Mayel-dev/mesa-voice/hardware/previews/mesa-voice.png

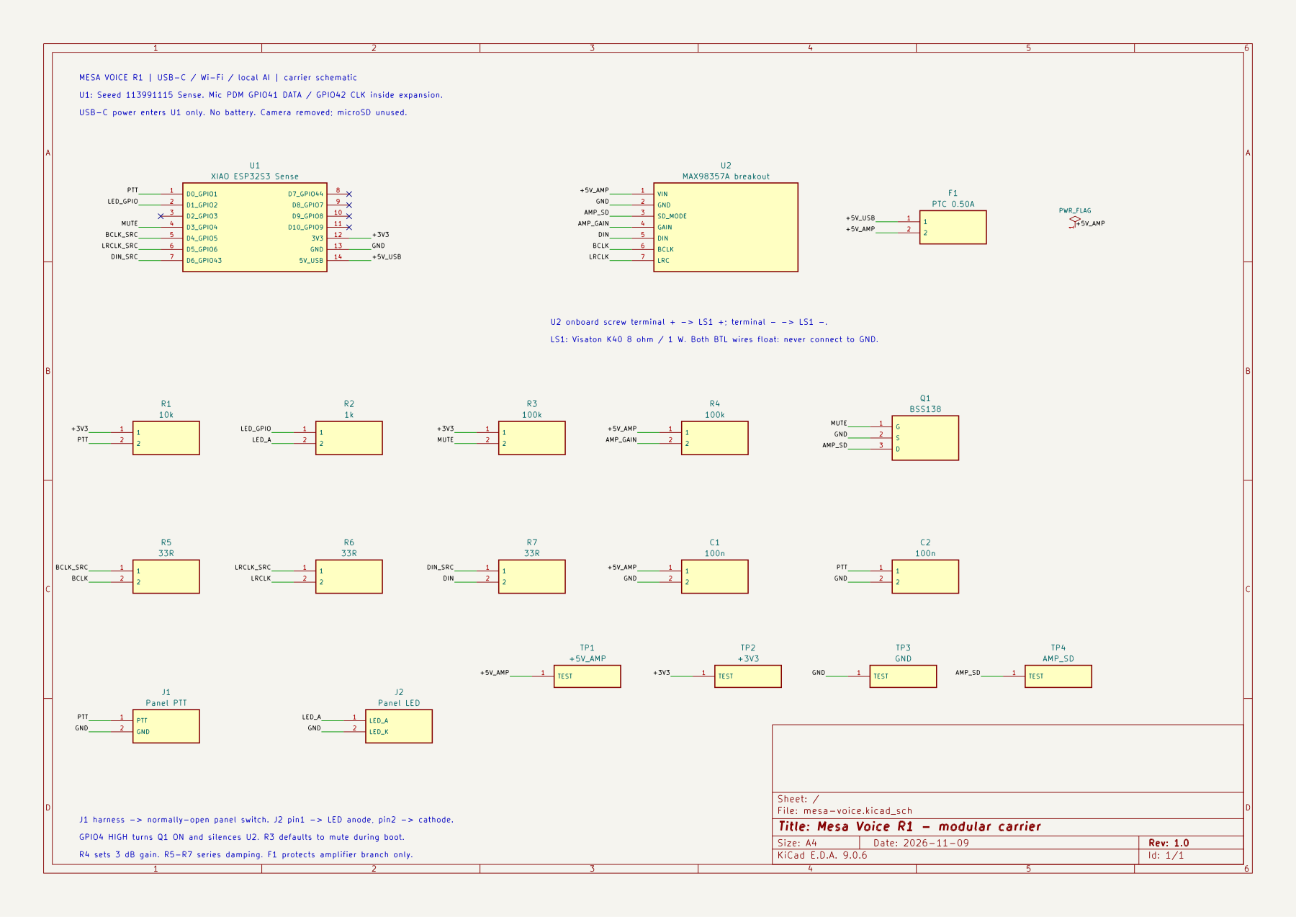
hardware/previews/mesa-voice.png
