Mayel-dev/mesa-voice/hardware/previews/pcb-back.png

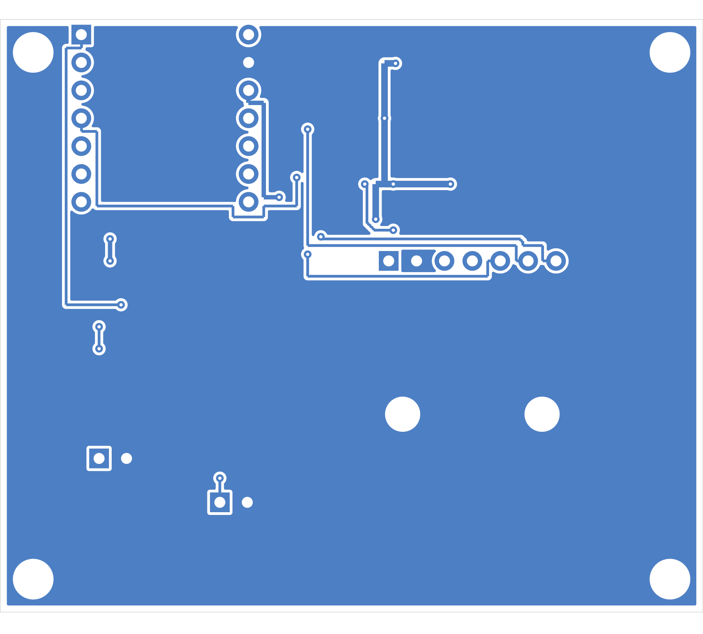
hardware/previews/pcb-back.png
