Mayel-dev/mesa-voice/hardware/previews/pcb-front.png

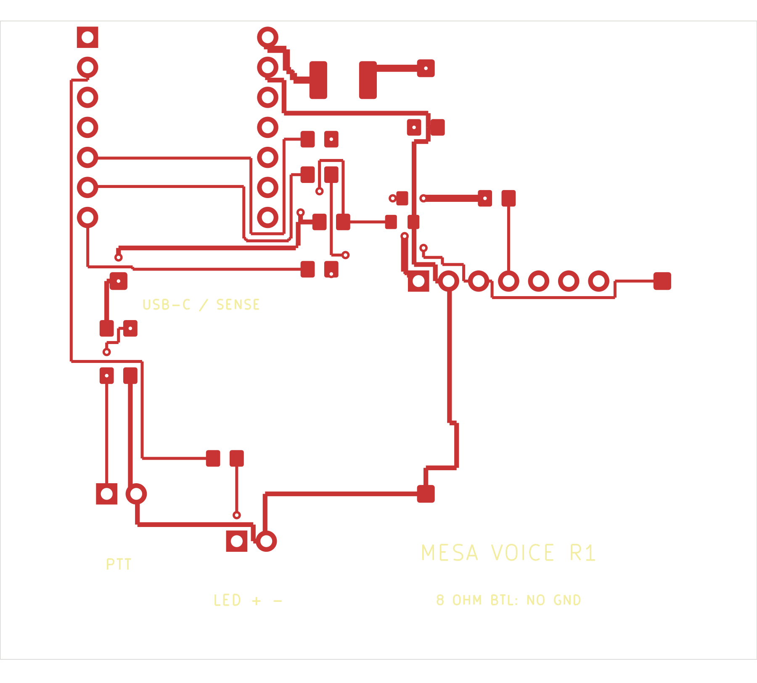
hardware/previews/pcb-front.png
