Mayel-dev/mesa-voice/mechanical/base.png

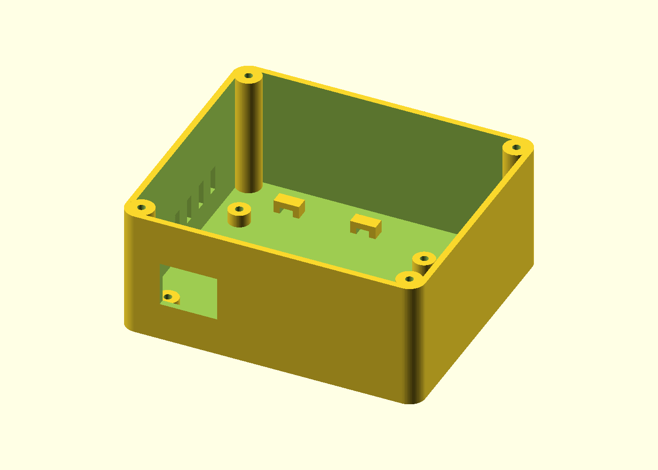
mechanical/base.png
