Mayel-dev/mesa-voice/mechanical/lid.png

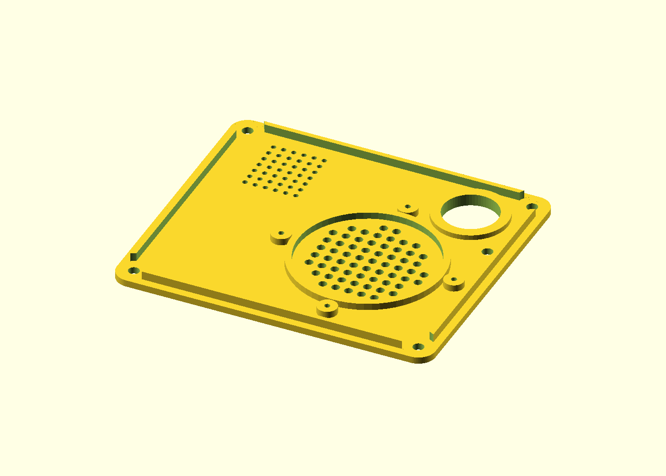
mechanical/lid.png
