Mayel-dev/mesa-voice/mechanical/stl/base.stl

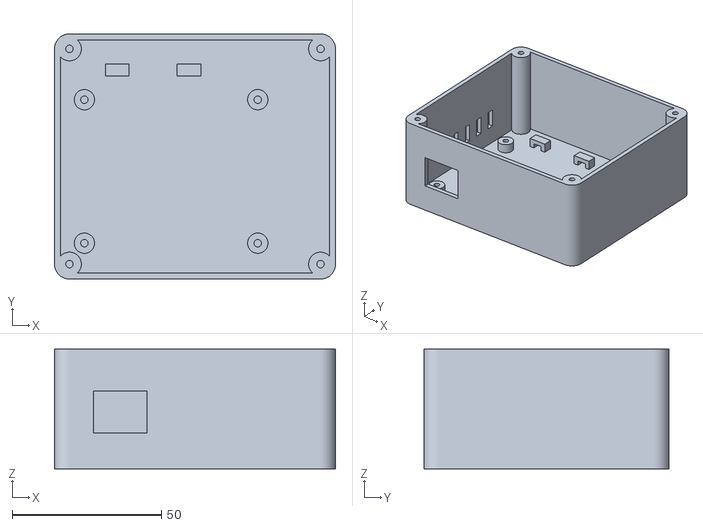
[picture p7: CAD file, 2026-11-11]
mechanical/stl/base.stl
94.0 x 82.0 x 40.0
