Mayel-dev/mesa-voice/mechanical/stl/lid.stl

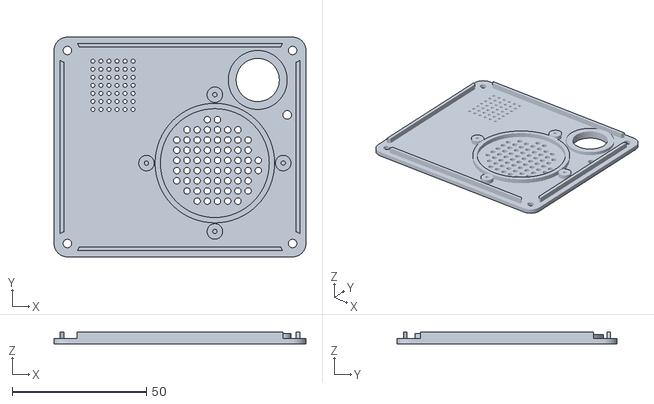
[picture p8: CAD file, 2026-11-11]
mechanical/stl/lid.stl
94.0 x 82.0 x 4.50
