Mayel-dev/mesa-voice/mechanical/stl/speaker_clamp.stl

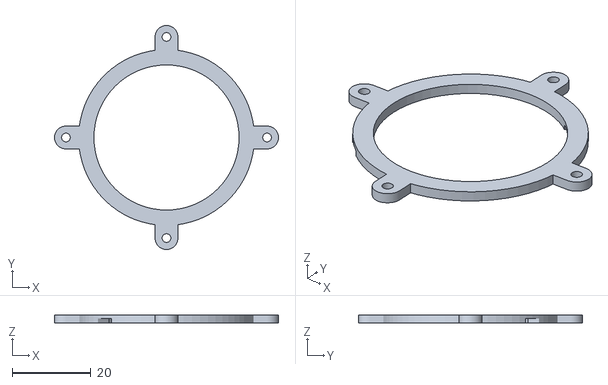
[picture p9: CAD file, 2026-11-11]
mechanical/stl/speaker_clamp.stl
56.8 x 56.8 x 2.00
