Mayel-dev/mesa-voice/hardware/previews/assembly.png

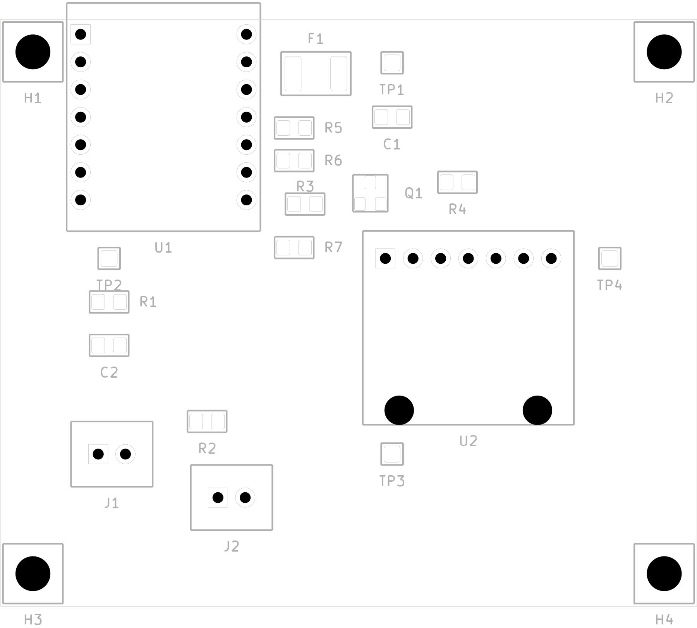
hardware/previews/assembly.png
