Mayel-dev/mesa-voice/hardware/previews/wiring.png

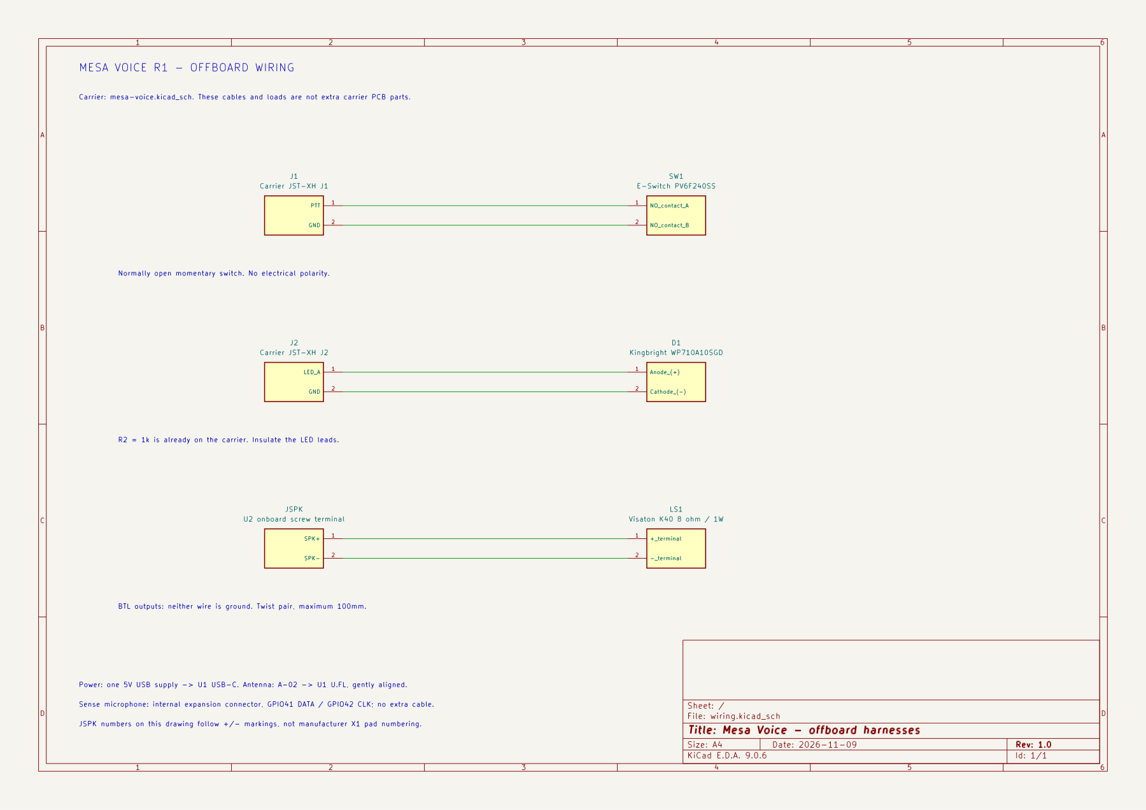
hardware/previews/wiring.png
