Mayel-dev/mesa-voice/backend/requirements-lock-tested.txt

annotated-types==0.8.0
anyio==4.16.0
certifi==2026.10.23
click==8.1.7
colorama==0.4.6
fastapi==0.115.12
h11==0.16.0
httpcore==1.0.9
httpx==0.28.1
idna==3.20
iniconfig==2.3.1
numpy==2.2.6
packaging==26.3
pluggy==1.7.0
pydantic==2.14.3
pydantic-core==2.50.4
pytest==8.3.5
scipy==1.15.3
starlette==0.46.2
typing-extensions==4.16.0
typing-inspection==0.4.5
uvicorn==0.34.2
