Mayel-dev/mesa-voice/hardware/mesa-voice.kicad_pcb

## KiCad design hardware/mesa-voice.kicad_pcb (2026-11-11)

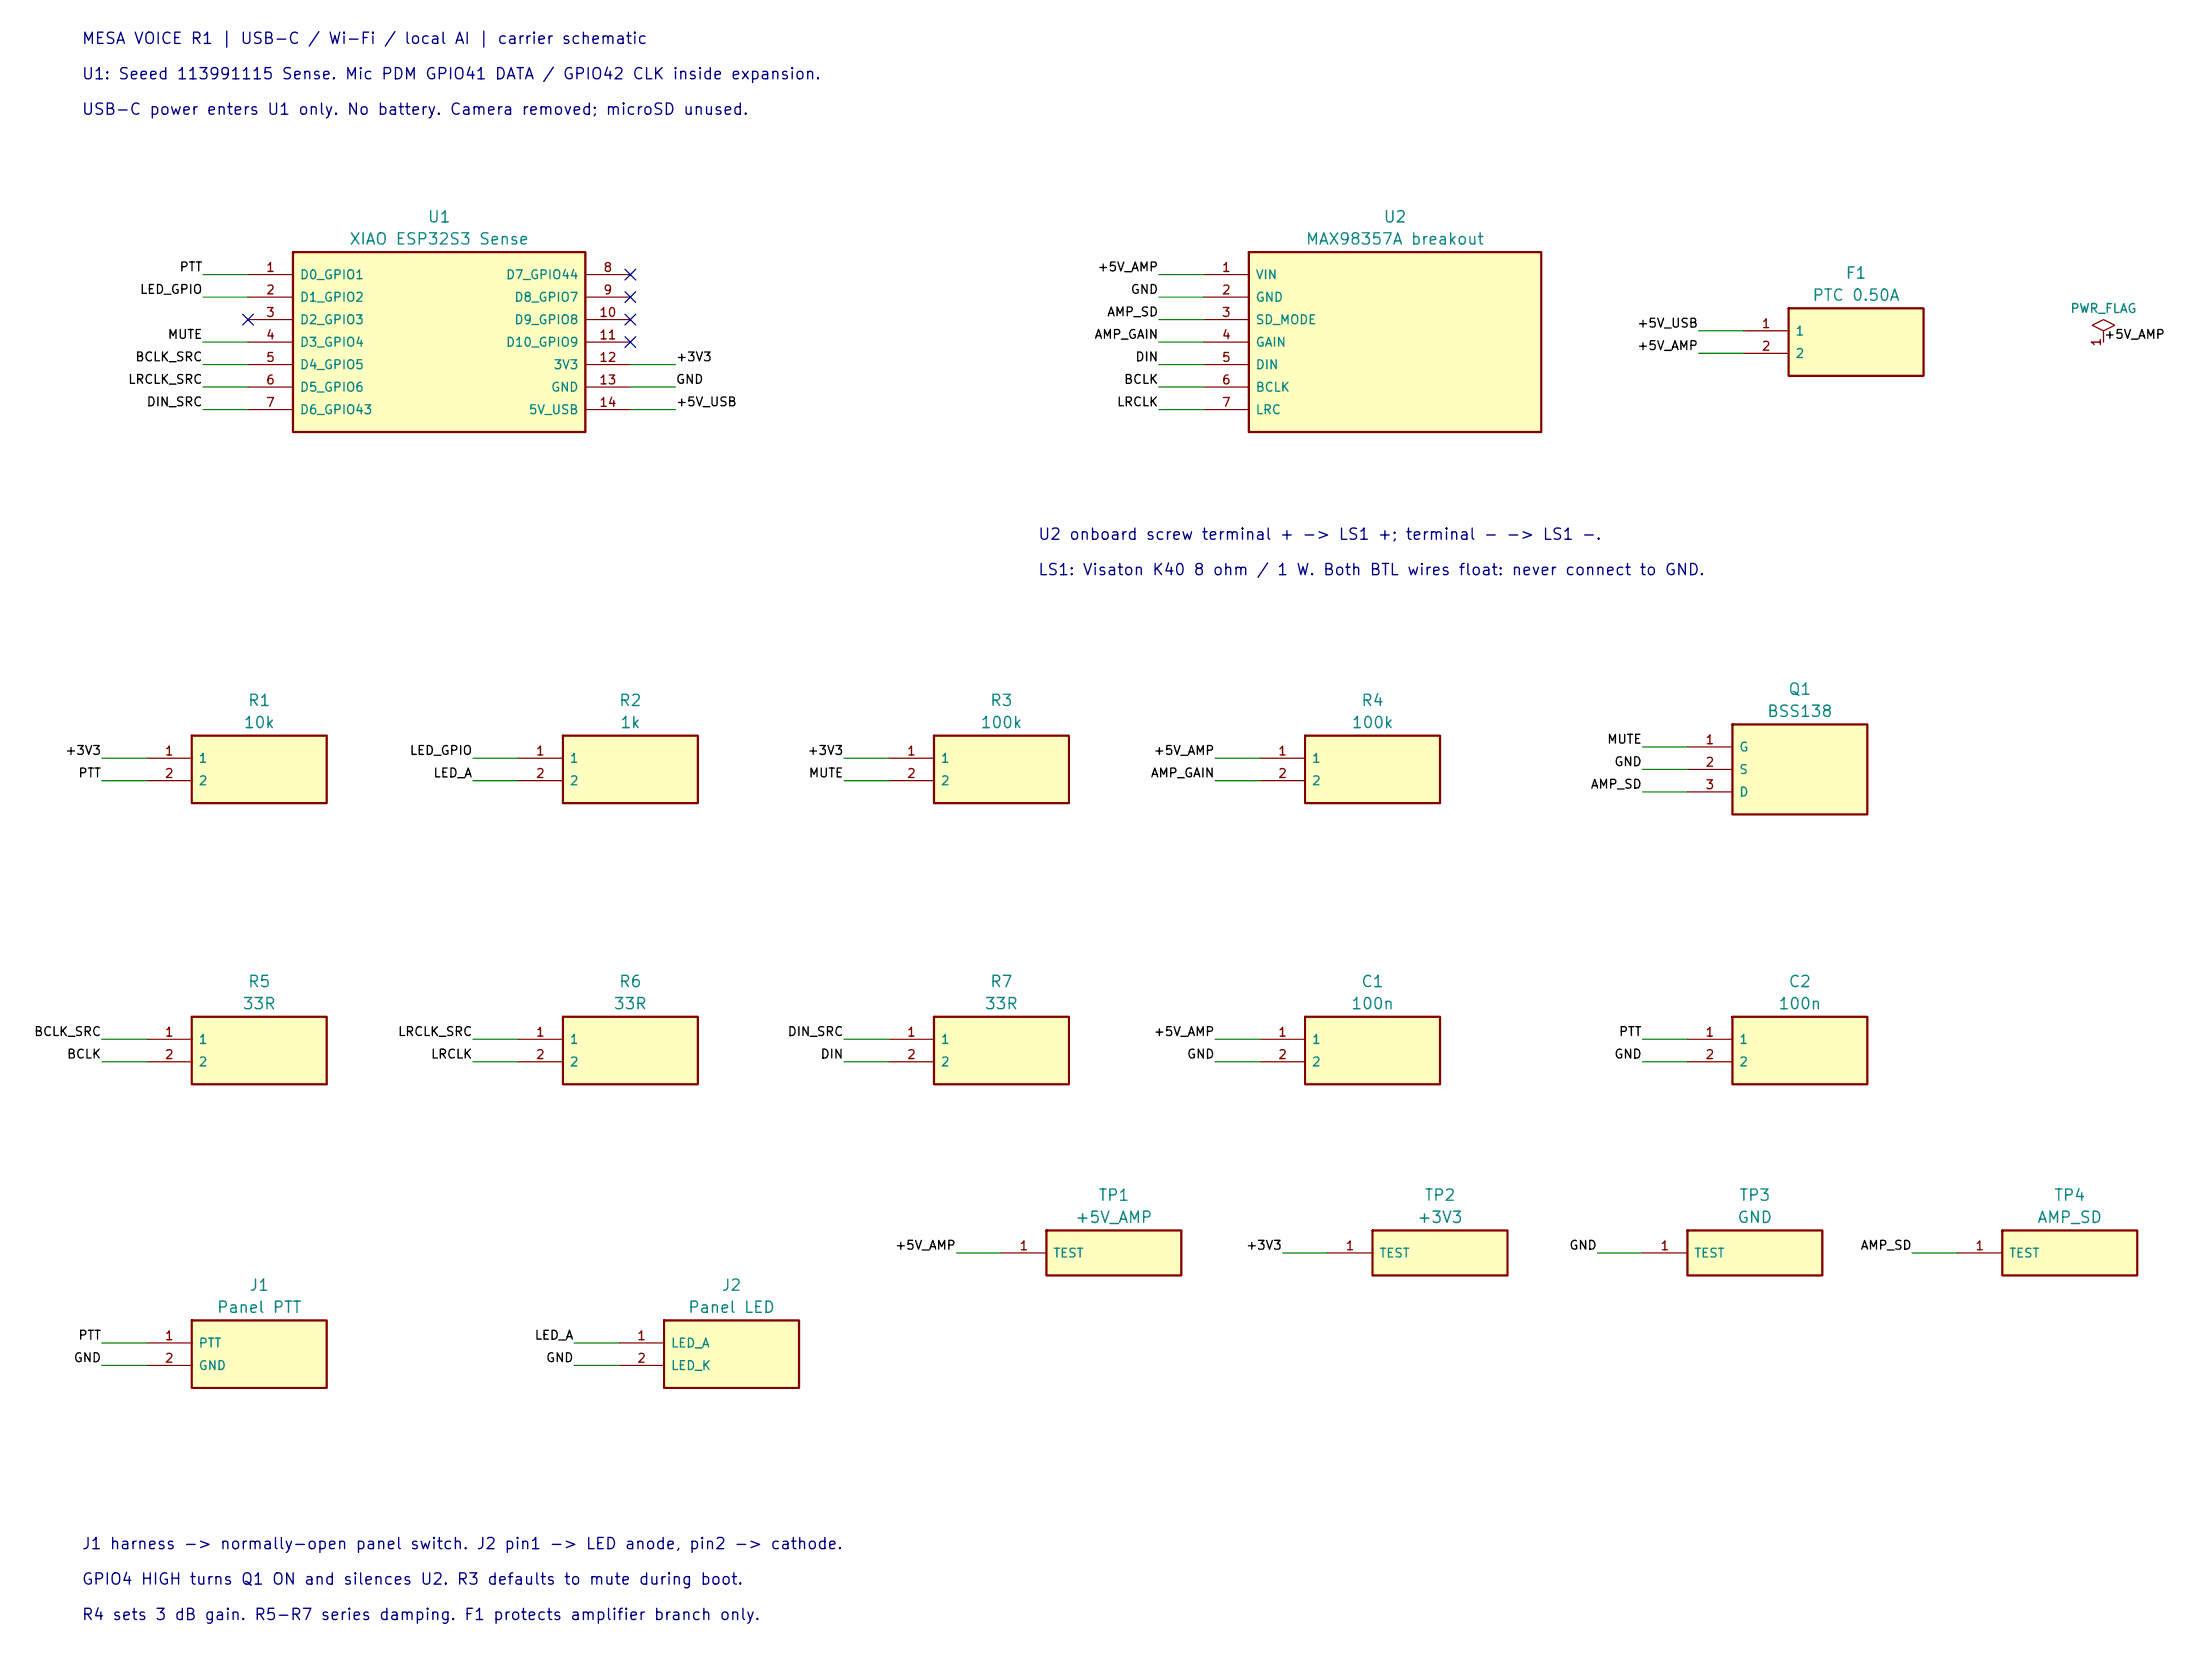
[picture p12: schematic mesa-voice.kicad_sch, Mesa Voice R1 - modular carrier]

Parts:
C1: 100n; C1; MPN Murata GRM21BR71C104KA01L
C2: 100n; C2; MPN Murata GRM21BR71C104KA01L
F1: PTC 0.50A; F1; MPN Bourns MF-MSMF050-2
J1: Panel PTT; J1; MPN JST B2B-XH-A(LF)(SN)
J2: Panel LED; J2; MPN JST B2B-XH-A(LF)(SN)
Q1: BSS138; Q1; MPN onsemi BSS138LT1G
R1: 10k; R1; MPN Yageo RC0805FR-0710KL
R2: 1k; R2; MPN Yageo RC0805FR-071KL
R3: 100k; R3; MPN Yageo RC0805FR-07100KL
R4: 100k; R4; MPN Yageo RC0805FR-07100KL
R5: 33R; R5; MPN Yageo RC0805FR-0733RL
R6: 33R; R6; MPN Yageo RC0805FR-0733RL
R7: 33R; R7; MPN Yageo RC0805FR-0733RL
TP1: +5V_AMP; TP1; MPN PCB test pad
TP2: +3V3; TP2; MPN PCB test pad
TP3: GND; TP3; MPN PCB test pad
TP4: AMP_SD; TP4; MPN PCB test pad
U1: XIAO ESP32S3 Sense; U1; MPN Seeed 113991115
U2: MAX98357A breakout; U2; MPN Adafruit 3006

Connections:
/+3V3: R1.1, R3.1, TP2.1, U1.12 (3V3)
/+5V_AMP: C1.1, F1.2, R4.1, TP1.1, U2.1 (VIN)
/+5V_USB: F1.1, U1.14 (5V_USB)
/AMP_GAIN: R4.2, U2.4 (GAIN)
/AMP_SD: Q1.3 (D), TP4.1, U2.3 (SD_MODE)
/BCLK: R5.2, U2.6 (BCLK)
/BCLK_SRC: R5.1, U1.5 (D4_GPIO5)
/DIN: R7.2, U2.5 (DIN)
/DIN_SRC: R7.1, U1.7 (D6_GPIO43)
/GND: C1.2, C2.2, J1.2 (GND), J2.2 (LED_K), Q1.2 (S), TP3.1, U1.13 (GND), U2.2 (GND)
/LED_A: J2.1 (LED_A), R2.2
/LED_GPIO: R2.1, U1.2 (D1_GPIO2)
/LRCLK: R6.2, U2.7 (LRC)
/LRCLK_SRC: R6.1, U1.6 (D5_GPIO6)
/MUTE: Q1.1 (G), R3.2, U1.4 (D3_GPIO4)
/PTT: C2.1, J1.1 (PTT), R1.2, U1.1 (D0_GPIO1)

Notes on the sheet:
MESA VOICE R1 | USB-C / Wi-Fi / local AI | carrier schematic
U1: Seeed 113991115 Sense. Mic PDM GPIO41 DATA / GPIO42 CLK inside expansion.
USB-C power enters U1 only. No battery. Camera removed; microSD unused.
U2 onboard screw terminal + -> LS1 +; terminal - -> LS1 -.
LS1: Visaton K40 8 ohm / 1 W. Both BTL wires float: never connect to GND.
J1 harness -> normally-open panel switch. J2 pin1 -> LED anode, pin2 -> cathode.
GPIO4 HIGH turns Q1 ON and silences U2. R3 defaults to mute during boot.
R4 sets 3 dB gain. R5-R7 series damping. F1 protects amplifier branch only.

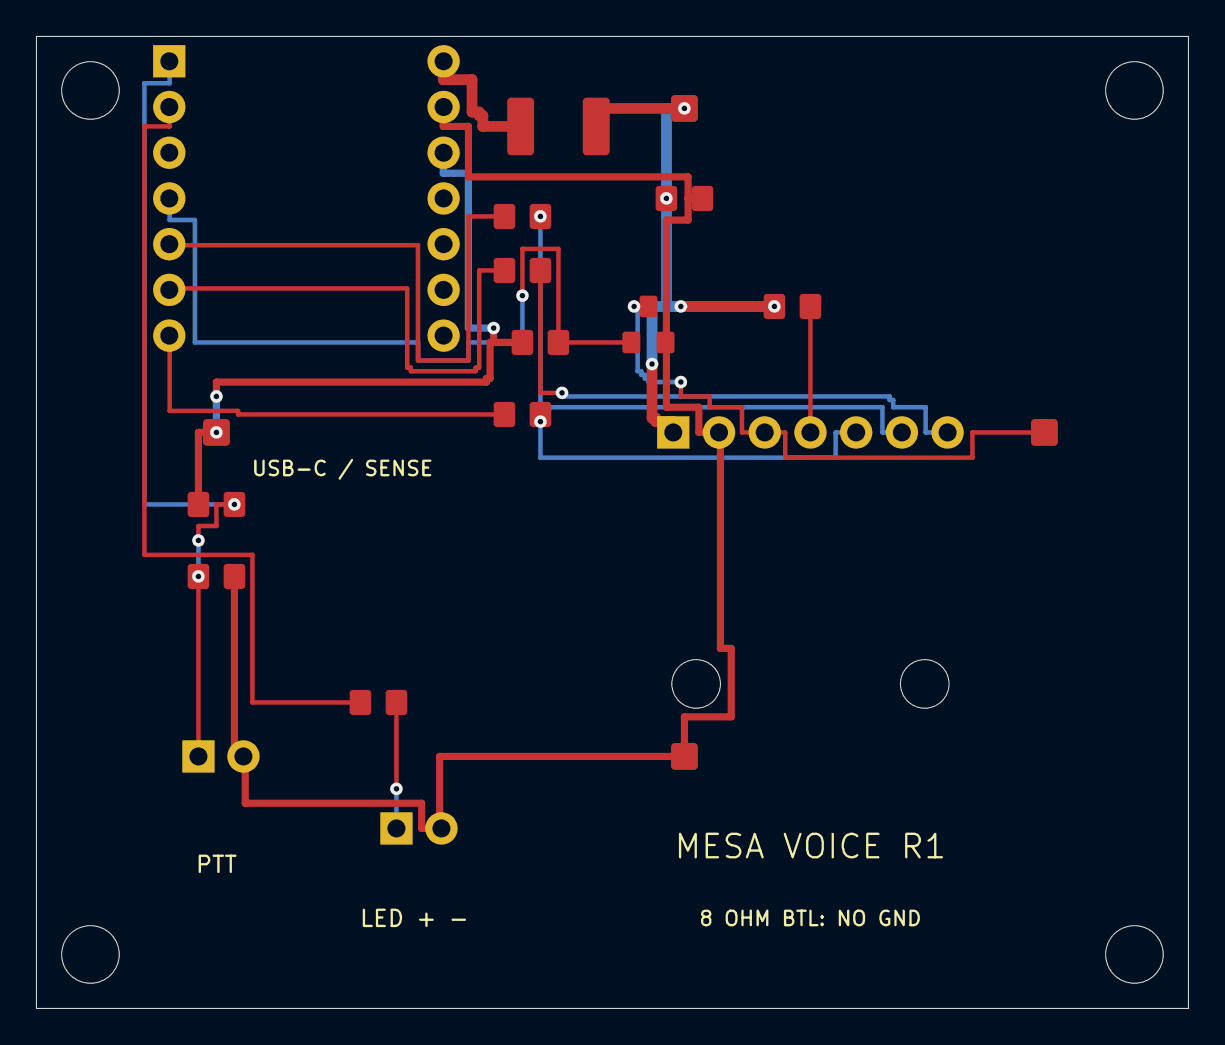
[picture p13: board mesa-voice.kicad_pcb from above]

Board: 2 copper layers, 64.0 x 54.0 mm, 23 parts (0 on the bottom side), 16 nets.

Other parts of the board:
H1: M3; H1
H2: M3; H2
H3: M3; H3
H4: M3; H4
