Mayel-dev/mesa-voice/hardware/references/adafruit-3006.brd

## EAGLE design hardware/references/adafruit-3006.brd (2026-11-11)


Parts:
C1: 0.1uF; 0805-NO
C2: 10uF; 0805-NO
C4, C5: 220pF; 0805-NO
FB1, FB2: Ferrite; 0805-NO
FID1, FID2: FIDUCIAL""; FIDUCIAL_1MM
JP1: HEADER-1X7THICKER; 1X07_ROUND_76
R1: 1M; 0805-NO
U1: MAX98357A; QFN16_3MM
U$9, U$10: MOUNTINGHOLE2.5; MOUNTINGHOLE_2.5_PLATED
X1: TERMBLOCK_1X2; TERMBLOCK_1X2-3.5MM

Connections:
BCLK: JP1.6, U1.16 (BCLK)
DIN: JP1.5, U1.1 (DIN)
GAIN: JP1.4, U1.2 (GAIN)
GND: C1.2, C2.2, C4.2, C5.2, JP1.2, U1.3 (GND), U1.11 (GND), U1.15 (GND), U1.THERMAL (GND)
LRCLK: JP1.7, U1.14 (LRCLK)
unnamed: FB2.1, U1.10 (OUTN)
unnamed: FB1.1, U1.9 (OUTP)
SD_MODE: JP1.3, R1.1, U1.4 (!SD_MODE)
VDD: C1.1, C2.1, JP1.1, R1.2, U1.7 (VDD), U1.8 (VDD)
VO+: C5.1, FB1.2, X1.2
VO-: C4.1, FB2.2, X1.1

Notes on the sheet:
R1 Channel Selection: LEFT = VDD (0 Ohm) RIGHT = 370K (94*VDD-100) LEFT/2 + RIGHT/2 = 1.011M (222.2*VDD-100)
ToDo: Ferrite (select w/high Z at high F, low Z at low F). Try to block everything >1MHz or so.
Gain=9dB


Board: 2 copper layers, 17.8 x 19.1 mm, 18 parts (1 on the bottom side), 11 nets.

Other parts of the board:
U$6: SYMBOL_PLUS
U$11: SYMBOL_MINUS
U$14: ADAFRUIT_2.5MM
U$15: PCBFEAT-REV-040
