Mayel-dev/mesa-voice/firmware/include/config.example.h

#pragma once
// Copy this file to secrets.h. Do not commit credentials or flash an example token.
constexpr char WIFI_SSID[] = "";
constexpr char WIFI_PASSWORD[] = "";
// IPv4 or DNS hostname only, without scheme/path; HTTP over a trusted LAN.
constexpr char SERVER_HOST[] = "192.168.1.50";
constexpr unsigned short SERVER_PORT = 8000;
constexpr char API_TOKEN[] = ""; // Same token as the backend; at least 32 characters.
